eriknyquist/arduinozero-metronome/images/metronome_screen.png

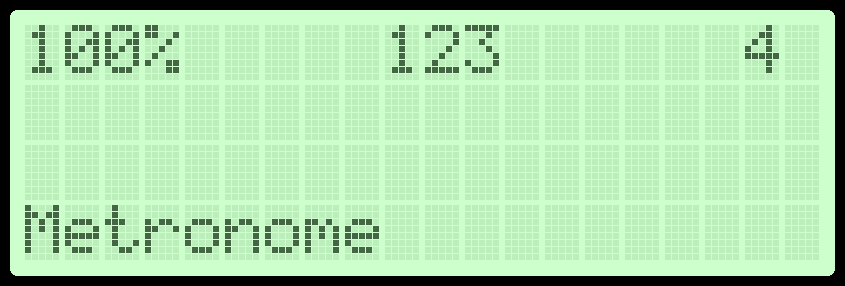
images/metronome_screen.png
