eriknyquist/arduinozero-metronome/images/name_entry_screen.png

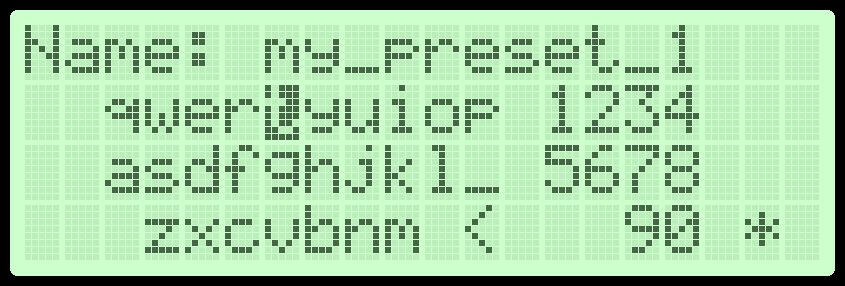
images/name_entry_screen.png
