eriknyquist/arduinozero-metronome/images/preset_edit_screen.png

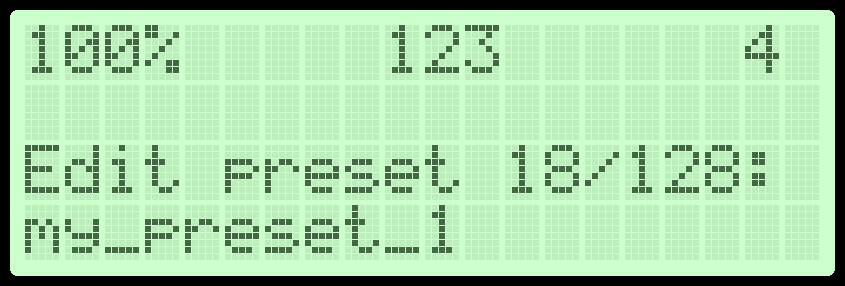
images/preset_edit_screen.png
