eriknyquist/arduinozero-metronome/images/preset_playback_screen.png

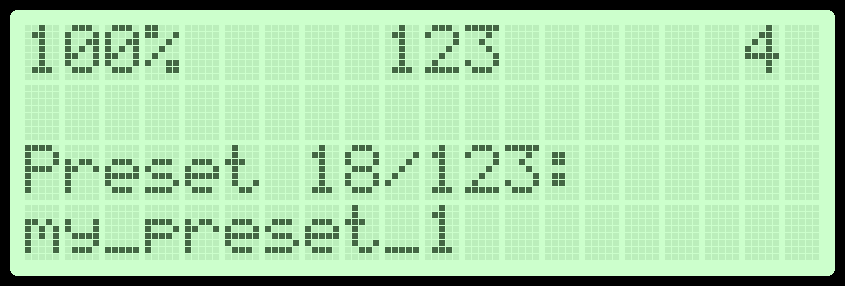
images/preset_playback_screen.png
