eriknyquist/arduinozero-metronome/metronome/ModifiedI2S.cpp

/*
  Copyright (c) 2016 Arduino LLC.  All right reserved.

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

  Modified by Erik K. Nyquist for the Arduino Zero Stage Metronome project. These
  changes were found to be needed in order to ensure clean playback of metronome
  beep sounds without any unpleasant pops/clicks. Specifically, disabling the I2S
  hardware via 'i2sd.disable()' after all samples for a sound have been sent
  seemed to eliminate unwanted artifacts.

  * Renamed I2S class to ModifiedI2S so as not to be confused with original I2S lib
  * Added ModifiedI2S.enable(), ModifiedI2S.disable(), and
    ModifiedI2S.remainingBytesToTransmit() functions.
*/

#include <Arduino.h>
#include <wiring_private.h>

#include "DMA.h"
#include "SAMD21_I2SDevice.h"

static I2SDevice_SAMD21G18x i2sd(*I2S);

#include "ModifiedI2S.h"

int ModifiedI2SClass::_beginCount = 0;

ModifiedI2SClass::ModifiedI2SClass(uint8_t deviceIndex, uint8_t clockGenerator, uint8_t sdPin, uint8_t sckPin, uint8_t fsPin) :
  _deviceIndex(deviceIndex),
  _clockGenerator(clockGenerator),
  _sdPin(sdPin),
  _sckPin(sckPin),
  _fsPin(fsPin),

  _state(I2S_STATE_IDLE),
  _dmaChannel(-1),
  _bitsPerSample(0),
  _dmaTransferInProgress(false),

  _onTransmit(NULL),
  _onReceive(NULL)
{
}

int ModifiedI2SClass::begin(int mode, long sampleRate, int bitsPerSample)
{
  // master mode (driving clock and frame select pins - output)
  return begin(mode, sampleRate, bitsPerSample, true);
}

int ModifiedI2SClass::begin(int mode, int bitsPerSample)
{
  // slave mode (not driving clock and frame select pin - input)
  return begin(mode, 0, bitsPerSample, false);
}

int ModifiedI2SClass::begin(int mode, long sampleRate, int bitsPerSample, bool driveClock)
{
  if (_state != I2S_STATE_IDLE) {
    return 0;
  }

  switch (mode) {
    case I2S_PHILIPS_MODE:
    case I2S_RIGHT_JUSTIFIED_MODE:
    case I2S_LEFT_JUSTIFIED_MODE:
      break;

    default:
      // invalid mode
      return 0;
  }

  switch (bitsPerSample) {
    case 8:
    case 16:
    case 32:
      _bitsPerSample = bitsPerSample;
      break;

    default:
      // invalid bits per sample
      return 0;
  }

  // try to allocate a DMA channel
  DMA.begin();

  _dmaChannel = DMA.allocateChannel();

  if (_dmaChannel < 0) {
    // no DMA channel available
    return 0;
  }

  if (_beginCount == 0) {
    // enable the I2S interface
    PM->APBCMASK.reg |= PM_APBCMASK_I2S;

    // reset the device
    i2sd.reset();
  }

  _beginCount++;

  if (driveClock) {
    // set up clock
    enableClock(sampleRate * 2 * bitsPerSample);

    i2sd.setSerialClockSelectMasterClockDiv(_deviceIndex);
    i2sd.setFrameSyncSelectSerialClockDiv(_deviceIndex);
  } else {
    // use input signal from SCK and FS pins
    i2sd.setSerialClockSelectPin(_deviceIndex);
    i2sd.setFrameSyncSelectPin(_deviceIndex);
  }

  // disable device before continuing
  i2sd.disable();

  if (mode == I2S_PHILIPS_MODE) {
    i2sd.set1BitDelay(_deviceIndex);
  } else {
    i2sd.set0BitDelay(_deviceIndex);
  }
  i2sd.setNumberOfSlots(_deviceIndex, 1);
  i2sd.setSlotSize(_deviceIndex, bitsPerSample);
  i2sd.setDataSize(_deviceIndex, bitsPerSample);

  pinPeripheral(_sckPin, PIO_COM);
  pinPeripheral(_fsPin, PIO_COM);

  if (mode == I2S_RIGHT_JUSTIFIED_MODE) {
    i2sd.setSlotAdjustedRight(_deviceIndex);
  } else {
    i2sd.setSlotAdjustedLeft(_deviceIndex);
  }

  i2sd.setClockUnit(_deviceIndex);

  pinPeripheral(_sdPin, PIO_COM);

  // done configure enable
  i2sd.enable();

  _doubleBuffer.reset();

  _enabled = true;

  return 1;
}

void ModifiedI2SClass::end()
{
  if (_dmaChannel > -1) {
    DMA.freeChannel(_dmaChannel);
  }

  _state = I2S_STATE_IDLE;
  _dmaTransferInProgress = false;

  i2sd.disableSerializer(_deviceIndex);
  i2sd.disableClockUnit(_deviceIndex);

  // set the pins back to input mode
  pinMode(_sdPin, INPUT);
  pinMode(_fsPin, INPUT);
  pinMode(_sckPin, INPUT);

  disableClock();

  _beginCount--;

  if (_beginCount == 0) {
    if (_enabled) {
        i2sd.disable();
    }

    // disable the I2S interface
    PM->APBCMASK.reg &= ~PM_APBCMASK_I2S;
  }

  _enabled = false;
}

int ModifiedI2SClass::available()
{
  if (_state != I2S_STATE_RECEIVER) {
    enableReceiver();
  }

  uint8_t enableInterrupts = ((__get_PRIMASK() & 0x1) == 0);
  size_t avail;

  // disable interrupts,
  __disable_irq();

  avail = _doubleBuffer.available();

  if (_dmaTransferInProgress == false && _doubleBuffer.available() == 0) {
    // no DMA transfer in progress, start a receive process
    _dmaTransferInProgress = true;

    DMA.transfer(_dmaChannel, i2sd.data(_deviceIndex), _doubleBuffer.data(), _doubleBuffer.availableForWrite());

    // switch to the next buffer for user output (will be empty)
    _doubleBuffer.swap();
  }

  if (enableInterrupts) {
    // re-enable the interrupts
    __enable_irq();
  }

  return avail;
}

union i2s_sample_t {
  uint8_t b8;
  int16_t b16;
  int32_t b32;
};

int ModifiedI2SClass::read()
{
  i2s_sample_t sample;

  sample.b32 = 0;

  read(&sample, _bitsPerSample / 8);

  if (_bitsPerSample == 32) {
    return sample.b32;
  } else if (_bitsPerSample == 16) {
    return sample.b16;
  } else if (_bitsPerSample == 8) {
    return sample.b8;
  } else {
    return 0;
  }
}

int ModifiedI2SClass::peek()
{
  uint8_t enableInterrupts = ((__get_PRIMASK() & 0x1) == 0);
  i2s_sample_t sample;

  sample.b32 = 0;

  // disable interrupts,
  __disable_irq();

  _doubleBuffer.peek(&sample, _bitsPerSample / 8);

  if (enableInterrupts) {
    // re-enable the interrupts
    __enable_irq();
  }

  if (_bitsPerSample == 32) {
    return sample.b32;
  } else if (_bitsPerSample == 16) {
    return sample.b16;
  } else if (_bitsPerSample == 8) {
    return sample.b8;
  } else {
    return 0;
  }
}

void ModifiedI2SClass::flush()
{
  // do nothing, writes are DMA triggered
}

size_t ModifiedI2SClass::write(uint8_t data)
{
  return write((int32_t)data);
}

size_t ModifiedI2SClass::write(const uint8_t *buffer, size_t size)
{
  return write((const void*)buffer, size);
}

int ModifiedI2SClass::availableForWrite()
{
  if (_state != I2S_STATE_TRANSMITTER) {
    enableTransmitter();
  }

  uint8_t enableInterrupts = ((__get_PRIMASK() & 0x1) == 0);
  size_t space;

  // disable interrupts,
  __disable_irq();

  space = _doubleBuffer.availableForWrite();

  if (enableInterrupts) {
    // re-enable the interrupts
    __enable_irq();
  }

  return space;
}

int ModifiedI2SClass::read(void* buffer, size_t size)
{
  if (_state != I2S_STATE_RECEIVER) {
    enableReceiver();
  }

  uint8_t enableInterrupts = ((__get_PRIMASK() & 0x1) == 0);

  // disable interrupts,
  __disable_irq();

  int read = _doubleBuffer.read(buffer, size);

  if (_dmaTransferInProgress == false && _doubleBuffer.available() == 0) {
    // no DMA transfer in progress, start a receive process
    _dmaTransferInProgress = true;

    DMA.transfer(_dmaChannel, i2sd.data(_deviceIndex), _doubleBuffer.data(), _doubleBuffer.availableForWrite());

    // switch to the next buffer for user output (will be empty)
    _doubleBuffer.swap();
  }

  if (enableInterrupts) {
    // re-enable the interrupts
    __enable_irq();
  }

  return read;
}

size_t ModifiedI2SClass::write(int sample)
{
  return write((int32_t)sample);
}

size_t ModifiedI2SClass::write(int32_t sample)
{
  if (_state != I2S_STATE_TRANSMITTER) {
    enableTransmitter();
  }

  // this is a blocking write
  while(!i2sd.txReady(_deviceIndex));

  i2sd.writeData(_deviceIndex, sample);

  i2sd.clearTxReady(_deviceIndex);

  return 1;
}

size_t ModifiedI2SClass::write(const void *buffer, size_t size)
{
  if (_state != I2S_STATE_TRANSMITTER) {
    enableTransmitter();
  }

  uint8_t enableInterrupts = ((__get_PRIMASK() & 0x1) == 0);
  size_t written;

  // disable interrupts,
  __disable_irq();

  written = _doubleBuffer.write(buffer, size);

  if (_dmaTransferInProgress == false && _doubleBuffer.available()) {
    // no DMA transfer in progress, start a transmit process
    _dmaTransferInProgress = true;

    DMA.transfer(_dmaChannel, _doubleBuffer.data(), i2sd.data(_deviceIndex), _doubleBuffer.available());

    // switch to the next buffer for input
    _doubleBuffer.swap();
  }

  if (enableInterrupts) {
    // re-enable the interrupts
    __enable_irq();
  }

  return written;
}

void ModifiedI2SClass::onTransmit(void(*function)(void))
{
  _onTransmit = function;
}

void ModifiedI2SClass::onReceive(void(*function)(void))
{
  _onReceive = function;
}

void ModifiedI2SClass::setBufferSize(int bufferSize)
{
  _doubleBuffer.setSize(bufferSize);
}

void ModifiedI2SClass::enable()
{
  GCLK->CLKCTRL.bit.CLKEN = 1;
  while (GCLK->STATUS.bit.SYNCBUSY);

  i2sd.enable();
  _enabled = true;
}

void ModifiedI2SClass::disable()
{
  GCLK->CLKCTRL.bit.CLKEN = 0;
  while (GCLK->STATUS.bit.SYNCBUSY);

  i2sd.disable();
  _enabled = false;
}

int ModifiedI2SClass::remainingBytesToTransmit()
{
    return _doubleBuffer.available();
}

void ModifiedI2SClass::enableClock(int divider)
{
  int div = SystemCoreClock / divider;
  int src = GCLK_GENCTRL_SRC_DFLL48M_Val;

  if (div > 255) {
    // divider is too big, use 8 MHz oscillator instead
    div = 8000000 / divider;
    src = GCLK_GENCTRL_SRC_OSC8M_Val;
  }

  // configure the clock divider
  while (GCLK->STATUS.bit.SYNCBUSY);
  GCLK->GENDIV.bit.ID = _clockGenerator;
  GCLK->GENDIV.bit.DIV = div;

  // use the DFLL as the source
  while (GCLK->STATUS.bit.SYNCBUSY);
  GCLK->GENCTRL.bit.ID = _clockGenerator;
  GCLK->GENCTRL.bit.SRC = src;
  GCLK->GENCTRL.bit.IDC = 1;
  GCLK->GENCTRL.bit.GENEN = 1;

  // enable
  while (GCLK->STATUS.bit.SYNCBUSY);
  GCLK->CLKCTRL.bit.ID = i2sd.glckId(_deviceIndex);
  GCLK->CLKCTRL.bit.GEN = _clockGenerator;
  GCLK->CLKCTRL.bit.CLKEN = 1;

  while (GCLK->STATUS.bit.SYNCBUSY);
}

void ModifiedI2SClass::disableClock()
{
  while (GCLK->STATUS.bit.SYNCBUSY);
  GCLK->GENCTRL.bit.ID = _clockGenerator;
  GCLK->GENCTRL.bit.SRC = GCLK_GENCTRL_SRC_DFLL48M_Val;
  GCLK->GENCTRL.bit.IDC = 1;
  GCLK->GENCTRL.bit.GENEN = 0;

  while (GCLK->STATUS.bit.SYNCBUSY);
  GCLK->CLKCTRL.bit.ID = i2sd.glckId(_deviceIndex);
  GCLK->CLKCTRL.bit.GEN = _clockGenerator;
  GCLK->CLKCTRL.bit.CLKEN = 0;

  while (GCLK->STATUS.bit.SYNCBUSY);
}

void ModifiedI2SClass::enableTransmitter()
{
  i2sd.setTxMode(_deviceIndex);
  i2sd.enableClockUnit(_deviceIndex);
  i2sd.enableSerializer(_deviceIndex);

  DMA.incSrc(_dmaChannel);
  DMA.onTransferComplete(_dmaChannel, ModifiedI2SClass::onDmaTransferComplete);
  DMA.setTriggerSource(_dmaChannel, i2sd.dmaTriggerSource(_deviceIndex));
  DMA.setTransferWidth(_dmaChannel, _bitsPerSample);

  _state = I2S_STATE_TRANSMITTER;
}

void ModifiedI2SClass::enableReceiver()
{
  i2sd.setRxMode(_deviceIndex);
  i2sd.enableClockUnit(_deviceIndex);
  i2sd.enableSerializer(_deviceIndex);

  DMA.incDst(_dmaChannel);
  DMA.onTransferComplete(_dmaChannel, ModifiedI2SClass::onDmaTransferComplete);
  DMA.setTriggerSource(_dmaChannel, i2sd.dmaTriggerSource(_deviceIndex));
  DMA.setTransferWidth(_dmaChannel, _bitsPerSample);

  _state = I2S_STATE_RECEIVER;
}

void ModifiedI2SClass::onTransferComplete(void)
{
  if (_state == I2S_STATE_TRANSMITTER) {
    // transmit complete

    if (_doubleBuffer.available()) {
      // output is available to transfer, start the DMA process for the current buffer

      DMA.transfer(_dmaChannel, _doubleBuffer.data(), i2sd.data(_deviceIndex), _doubleBuffer.available());

      // swap to the next user buffer for input
      _doubleBuffer.swap();
    } else {
      // no user data buffered to send
      _dmaTransferInProgress = false;
    }

    // call the users transmit callback if provided
    if (_onTransmit) {
      _onTransmit();
    }
  } else {
    // receive complete

    if (_doubleBuffer.available() == 0) {
      // the user has read all the current input, start the DMA process to fill it again
      DMA.transfer(_dmaChannel, i2sd.data(_deviceIndex), _doubleBuffer.data(), _doubleBuffer.availableForWrite());

      // swap to the next buffer that has previously been filled, so that the user can read it
      _doubleBuffer.swap(_doubleBuffer.availableForWrite());
    } else {
      // user has not read current data, no free buffer to transfer into
      _dmaTransferInProgress = false;
    }

    // call the users receveive callback if provided
    if (_onReceive) {
      _onReceive();
    }
  }
}

void ModifiedI2SClass::onDmaTransferComplete(int channel)
{
#if I2S_INTERFACES_COUNT > 0
  if (ModifiedI2S._dmaChannel == channel) {
    ModifiedI2S.onTransferComplete();
  }
#endif
}

#if I2S_INTERFACES_COUNT > 0
ModifiedI2SClass ModifiedI2S(I2S_DEVICE, I2S_CLOCK_GENERATOR, PIN_I2S_SD, PIN_I2S_SCK, PIN_I2S_FS);
#endif
