eriknyquist/arduinozero-metronome/metronome/metronome_beep_samples.h

/**
 * metronome_beep_samples.h
 * Erik K. Nyquist 2023
 *
 * This file contains audio data recorded from a Korg TM60 digital metronome/tuner
 * at 44.1 KHz (16-bit, stereo), encoded as arrays of int16_t values.
 *
 * high_beep_samples contains the samples for the high-pitched beep/click sound.
 *
 * low_beep_samples contains the samples for the low-pitched beep/click sound.
 *
 * Both the high-pitched and low-pitched beep/click sounds are the same number of
 * samples (#BEEP_SAMPLE_COUNT).
 */

#ifndef METRONOME_BEEP_SAMPLES_H
#define METRONOME_BEEP_SAMPLES_H


#include <stdint.h>

#define BEEP_SAMPLE_COUNT (7100u)


// 8KHz PCM samples for basic high beep sound
const int16_t high_beep_samples[BEEP_SAMPLE_COUNT] =
{
    0,
    0,
    51,
    51,
    -71,
    -70,
    274,
    271,
    -500,
    -496,
    3183,
    3179,
    11834,
    11837,
    12177,
    12176,
    13016,
    13016,
    12151,
    12151,
    12471,
    12471,
    11728,
    11729,
    11870,
    11868,
    11167,
    11169,
    11279,
    11278,
    10516,
    10516,
    10734,
    10735,
    9710,
    9709,
    10539,
    10539,
    6602,
    6603,
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
};

// 8KHz PCM samples for basic low beep sound
const int16_t low_beep_samples[BEEP_SAMPLE_COUNT] =
{
    0,
    0,
    39,
    38,
    -36,
    -34,
    187,
    185,
    -291,
    -288,
    1820,
    1816,
    11297,
    11300,
    12485,
    12483,
    12838,
    12840,
    12347,
    12346,
    12367,
    12367,
    11927,
    11927,
    11776,
    11775,
    11369,
    11371,
    11153,
    11150,
    10786,
    10789,
    10501,
    10499,
    10172,
    10172,
    9853,
    9855,
    9574,
    9570,
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
};

#endif // METRONOME_BEEP_SAMPLES_H
