eriknyquist/arduinozero-metronome/(commit log)

2023-06-17 Got timer interrupt working for metronome
2023-06-19 Working on preset switching
2023-06-20 Updates, fixes, add preset deletion
    [metronome.ino]
2023-06-21 Add command to power off & save presets
2023-06-22 Start adding PCM samples for beeps
    Arduino zero has enough flash to just store the samples directly
    for a few short 8KHz wav files (VERY short, like 50ms), so I guess
    that's what I'll do :)
    [metronome.ino, metronome_beep_samples.h]
2023-07-12 Small fixes, basic metronome & preset functionality is working
    [metronome.ino, metronome_beep_samples.h]
2023-10-21 Use 44.1Khz samples from korg metronome
2023-11-11 Update beep samples
2023-11-11 Fix some issues with changing beat count & BPM when running
    [metronome.ino]
2023-11-12 Move arduino code into subfolder
2023-11-13 Handle audio volume changes, & misc updates/fixes
    [metronome.ino]
2023-11-13 Fix issue causing I2S.end() to hang (caused by my own modifications)
    [ModifiedI2S.cpp, ModifiedI2S.h, metronome.ino]
2023-11-16 Add README section for solder bridges on HiLetgo I2S module
2023-11-16 arduino sketch: use LowPower.deepSleep() instead of sleep()
2023-11-16 Arduino sketch cleanup/comments
2023-11-16 Fix wrong pins for volume buttons
    [metronome.ino]
2023-11-18 Implement holding BPM buttons to increment/decrement faster
2023-11-18 Handle off switch, fix interrupt pins, fix compiler warnings
    [metronome.ino, metronome_config.h]
2023-11-18 Try to handle waking up without power cycle
2023-11-21 Update wiring diagram
2023-11-30 Remove incorrect comment, minor whitespace fix
    [metronome.ino]
